WilberCrz/Wilber-Cruz-PLC4UNI/Tarea 6/Render 3.jpeg

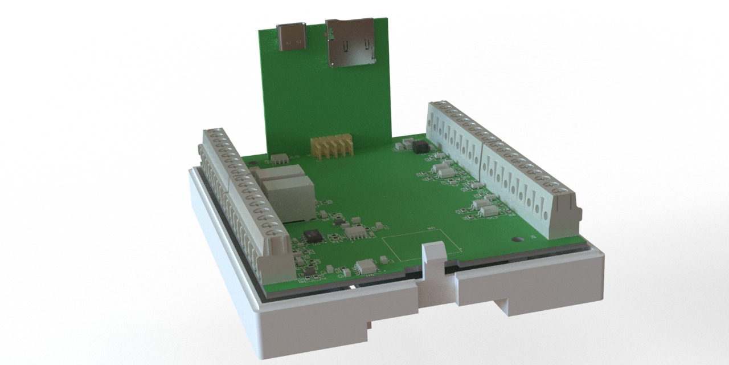
Tarea 6/Render 3.jpeg
