WilberCrz/Wilber-Cruz-PLC4UNI/Tarea 6/Etiqueta lateral.jpeg

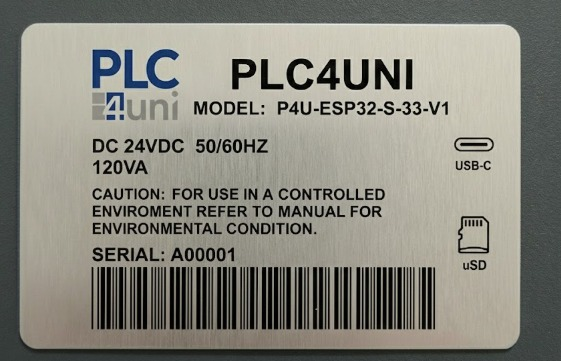
Tarea 6/Etiqueta lateral.jpeg
