WilberCrz/Wilber-Cruz-PLC4UNI/Tarea 5/Gemini_Generated_Image_hhtaqthhtaqthhta.png

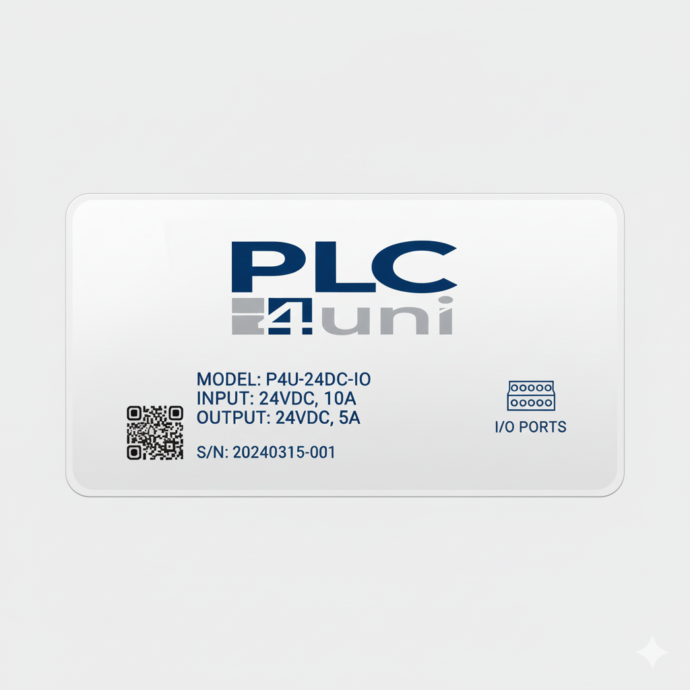
Tarea 5/Gemini_Generated_Image_hhtaqthhtaqthhta.png
