WilberCrz/Wilber-Cruz-PLC4UNI/Tarea 6/PLC4Uni Render2.jpeg

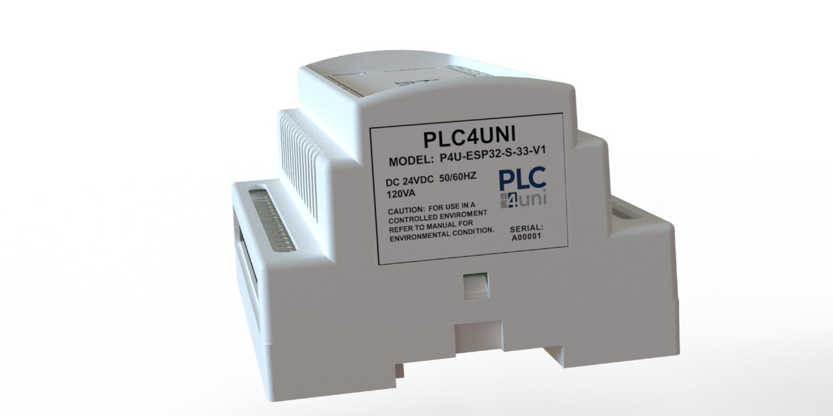
Tarea 6/PLC4Uni Render2.jpeg
