WilberCrz/Wilber-Cruz-PLC4UNI/PLC4UNIPCB/PIN2x5.FCStd

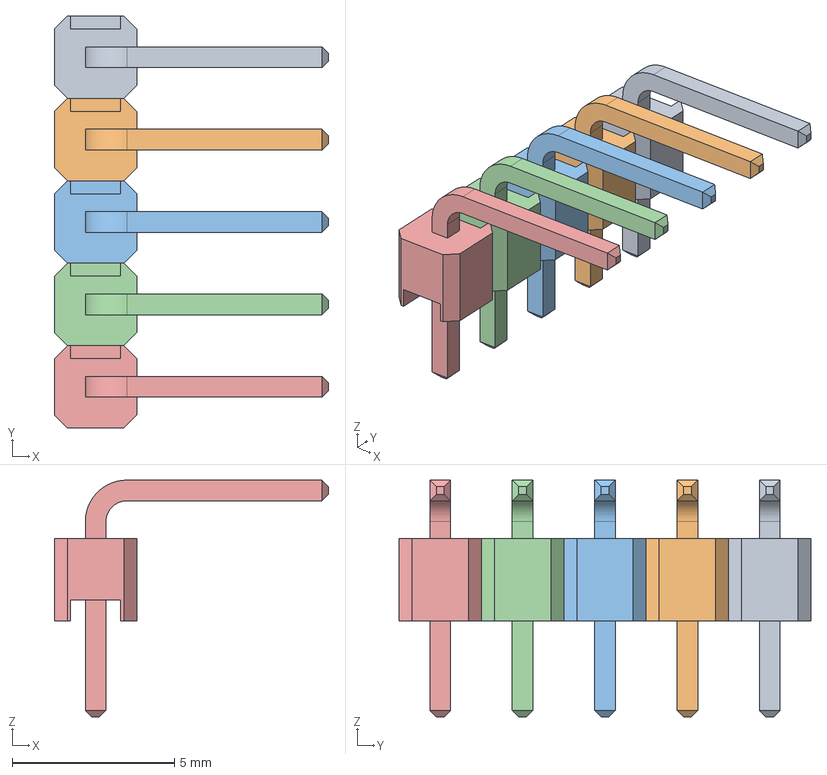
[picture p13: CAD file, 2025-12-03]
PLC4UNIPCB/PIN2x5.FCStd
8.45 x 12.7 x 7.30 mm
