WilberCrz/Wilber-Cruz-PLC4UNI/Tarea 2/PCL-4-UNI-208.FCStd

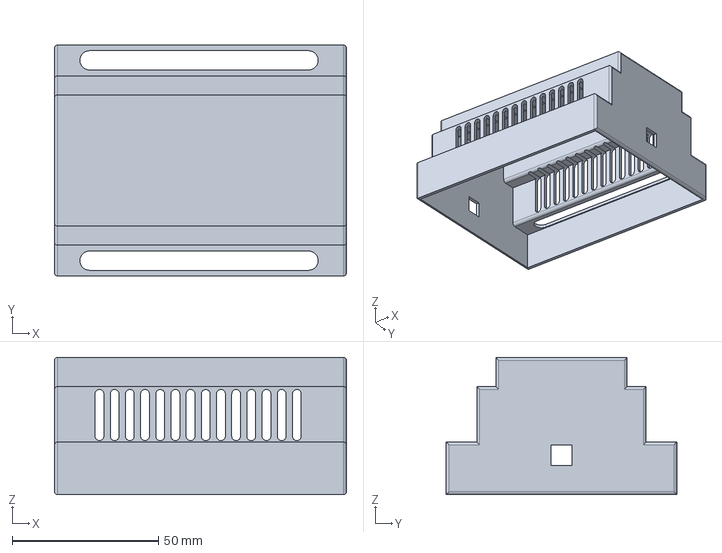
[picture p14: CAD file, 2025-09-25]
Tarea 2/PCL-4-UNI-208.FCStd
100.0 x 79.0 x 47.0 mm
