WilberCrz/Wilber-Cruz-PLC4UNI/Tarea 3/PLC-4-UNI-209-Body.dxf

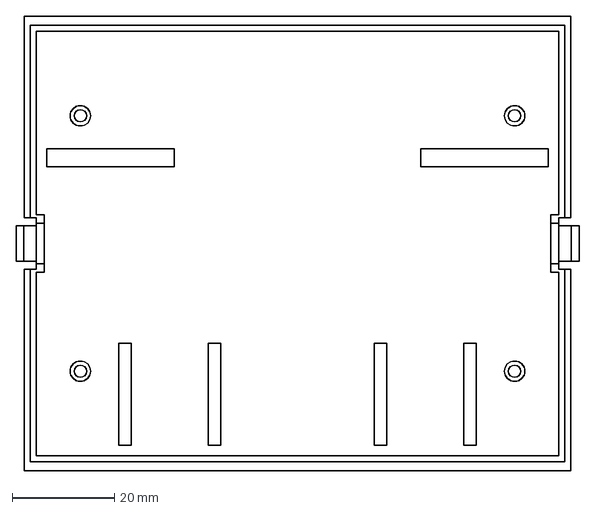
[picture p15: CAD file, 2025-10-09]
Tarea 3/PLC-4-UNI-209-Body.dxf
110.2 x 89.0 mm
