WilberCrz/Wilber-Cruz-PLC4UNI/Tarea 6/USB Type C Port (SMD Type) (1)[1].STEP

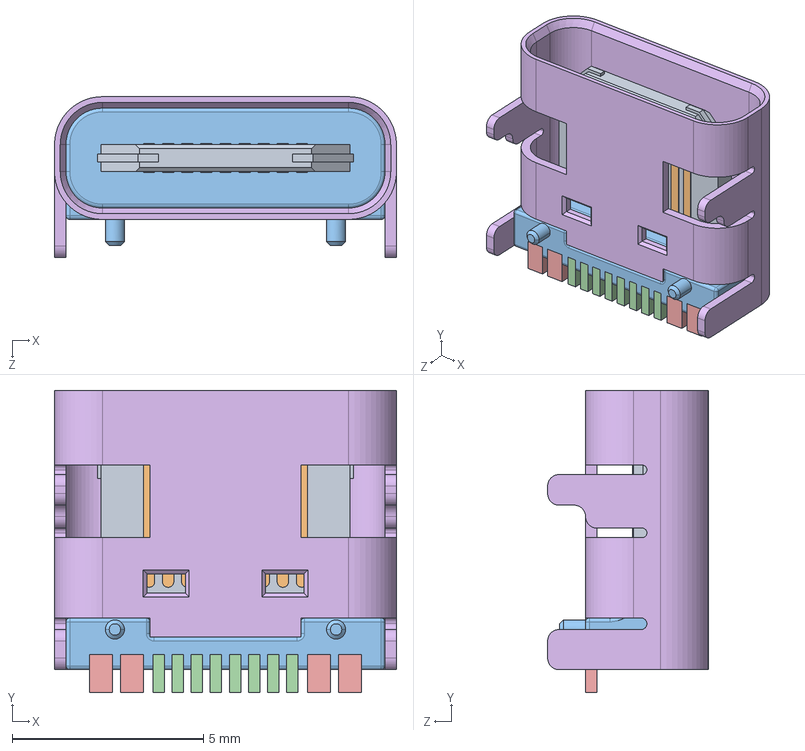
[picture p17: CAD file, 2025-12-02]
Tarea 6/USB Type C Port (SMD Type) (1)[1].STEP
8.94 x 7.90 x 4.20 mm
