WilberCrz/Wilber-Cruz-PLC4UNI/PLC4UNIPCB/PLC4UNIPCB.step

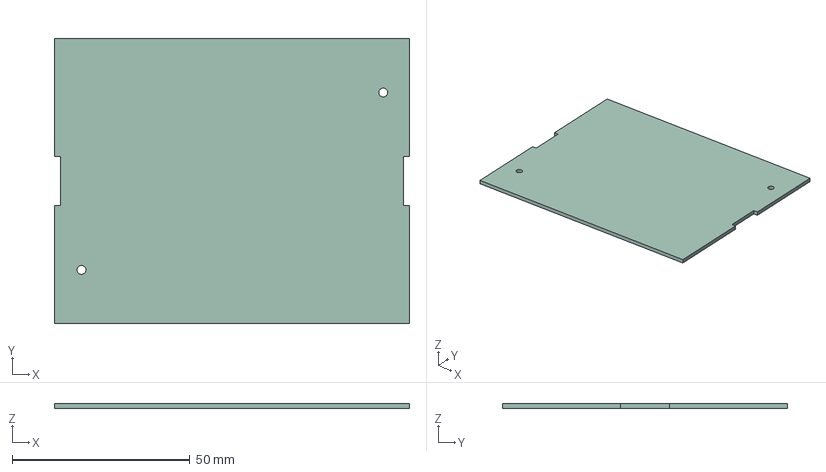
[picture p18: CAD file, 2025-12-03]
PLC4UNIPCB/PLC4UNIPCB.step
100.0 x 80.2 x 1.51 mm
