WilberCrz/Wilber-Cruz-PLC4UNI/Tarea 2/PLC-4-UNI-209.FCStd

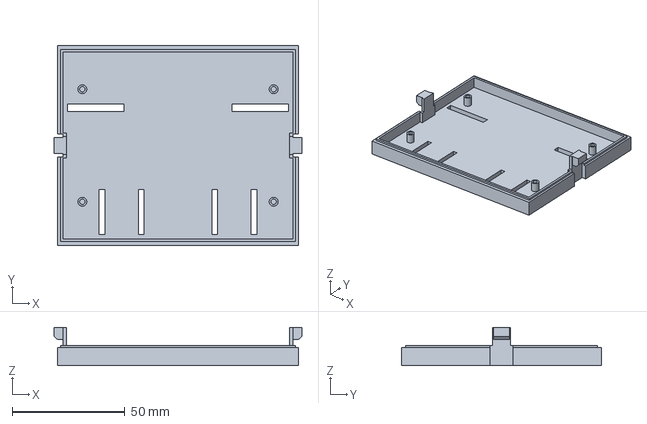
[picture p19: CAD file, 2025-09-25]
Tarea 2/PLC-4-UNI-209.FCStd
110.2 x 89.0 x 17.0 mm
