WilberCrz/Wilber-Cruz-PLC4UNI/Tarea 6/Same_Sky_MSD-4-A (1).step

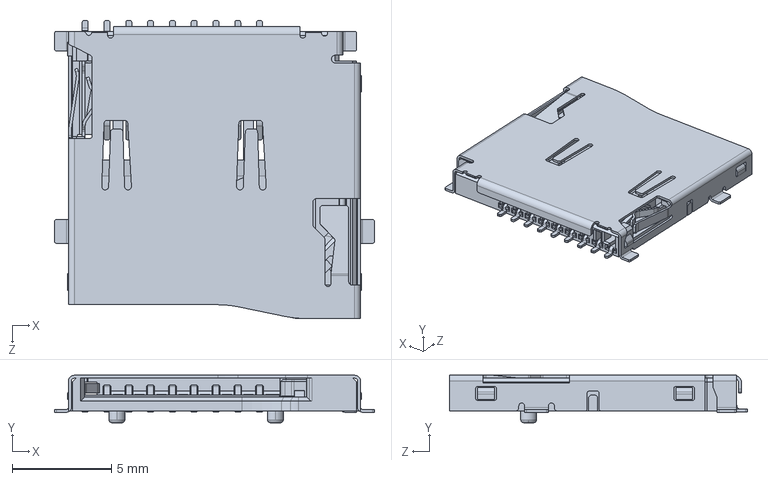
[picture p20: CAD file, 2025-12-02]
Tarea 6/Same_Sky_MSD-4-A (1).step
16.1 x 2.40 x 15.0 mm
