WilberCrz/Wilber-Cruz-PLC4UNI/Tarea 6/2x5 Male Pin Header Angle.STEP

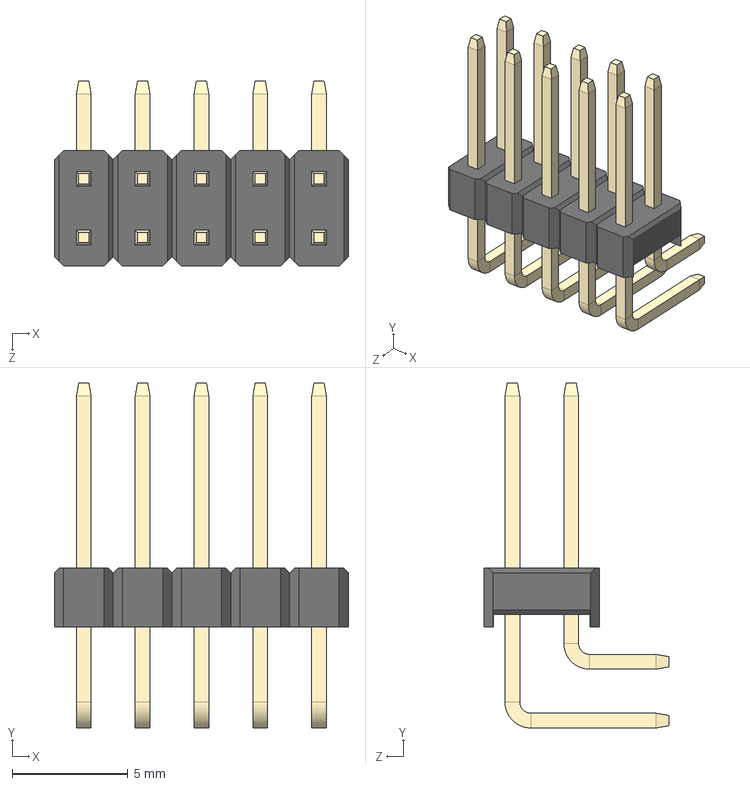
[picture p21: CAD file, 2025-12-02]
Tarea 6/2x5 Male Pin Header Angle.STEP
12.7 x 14.9 x 8.00 mm
