WilberCrz/Wilber-Cruz-PLC4UNI/(list of files, cad)

Other CAD files:
PLC4UNIPCB/PCBPLC4UNI.FCStd
