WilberCrz/Wilber-Cruz-PLC4UNI/(commit log)

2025-09-25 FreeCad 208
    [PCL-4-UNI-208.FCStd]
2025-10-09 Kicad con archivo DXF
    [PLC4UNIPCB.kicad_pcb, PLC4UNIPCB.kicad_sch]
2025-10-09 Imágenes de baja calidad arregladas.
2025-11-10 Add files via upload
    Actualización de Esquemáticos
    [Board-PLC4UNI-G1W.kicad_sch, CPU.kicad_sch, CT.kicad_sch, Input_0-10V.kicad_sch, Input_4-20mA.kicad_sch, OUT-RELAY-1.kicad_sch, OUT-RELAY-2.kicad_sch, Out_npn.kicad_sch]
2025-12-02 Add files via upload
    Tarea 4
    [2x5 Male Pin Header Angle.STEP, PCB Vertical (1).DXF, PCB Vertical.DXF, PLC4uni Ensamble.FCStd, Same_Sky_MSD-4-A (1).step, USB Type C Port (SMD Type) (1)[1].STEP]
